plan44/p44-mini-lx/(notices)

Notices in the files:
omega2ethernet.kicad_sch:
© 2024 by luz/plan44.ch
